LetsCodeBlacksburg/arduino-talking-skull/LCBB_Talking-Skull_Pt-2_Hware-Hacking-Guide.pdf

# Let’s Code Halloween Talking Skull Workshop Part-2 - Hardware Hacking Guide

# - Required Tools - Skull / Jaw-Servo Mod - Jaw Demo Video - Inline Resistors & LED Eyes

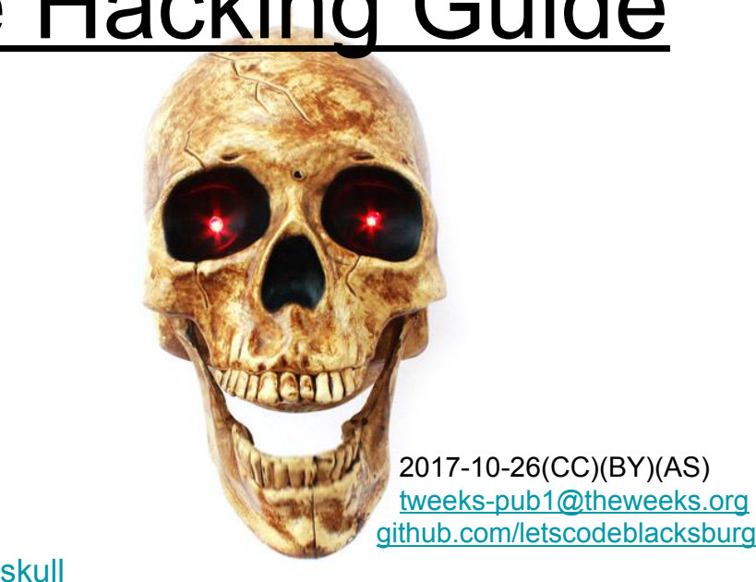
[picture p10: figure]
tweeks-pub1@theweeks.org

- Hardware Mounting` | 2017-10-26(CC)(BY)(AS)
Parts 1 & 2, parts list & source code all available at: | github.com/letscodeblacksburg
https://github.com/LetsCodeBlacksburg/arduino-talking-skull

# Required Tools

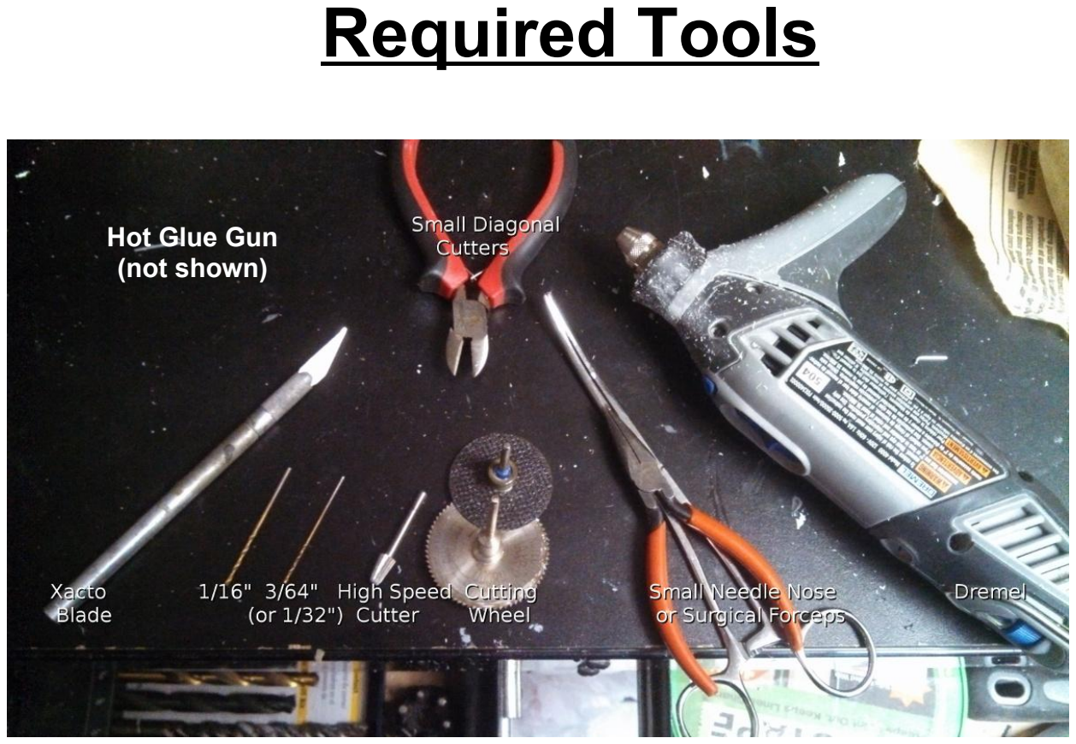
[picture p11: page 2]

Hot Glue Gun
(not shown)

# Skull Jaw Mods

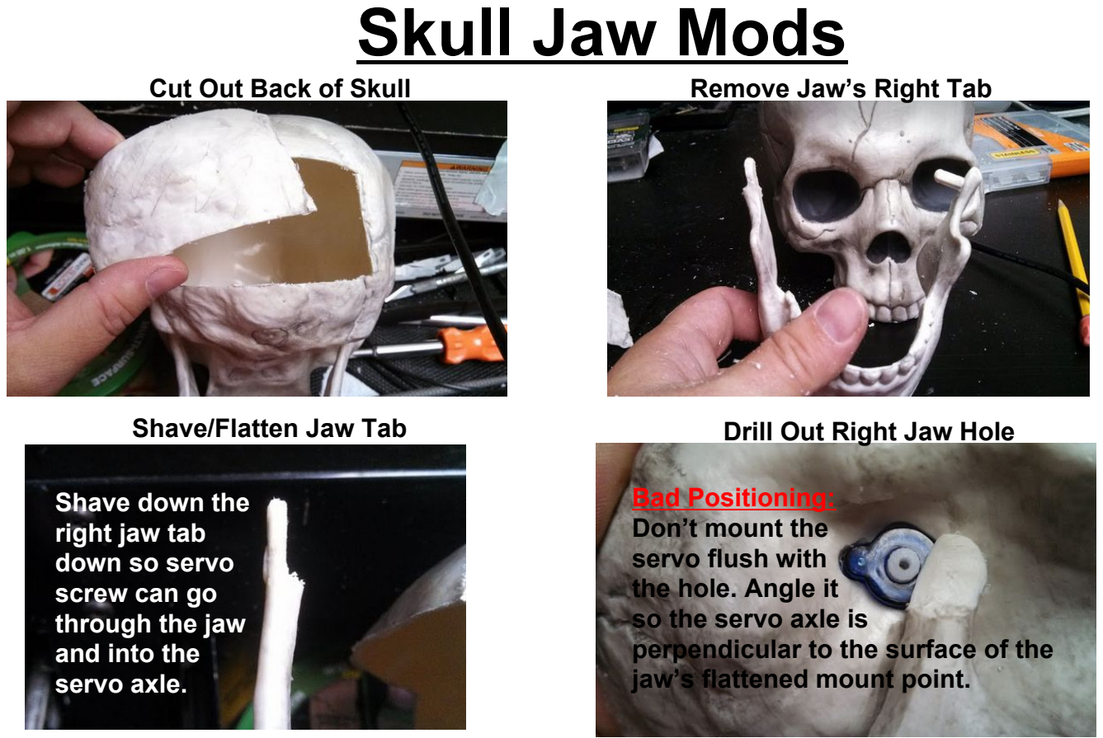
[picture p12: page 3]

Cut Out Back of Skull | Remove Jaw’s Right Tab

Drill Out Right Jaw Hole

Bad Positioning:
Don’t mount the
servo flush with
the hole. Angle it
so the servo axle is
perpendicular to the surface of the jaw’s flattened mount point.

Shave/Flatten Jaw Tab

Shave down the
right jaw tab
down so servo
screw can go
through the jaw
and into the
servo axle.

# Skull Jaw Mods

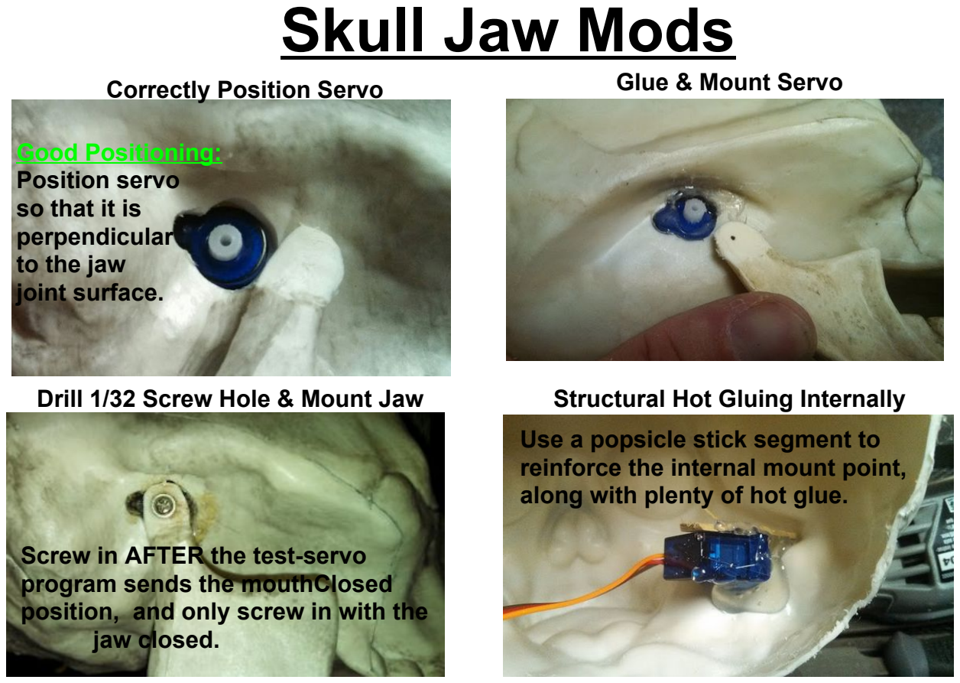
[picture p13: page 4]

Glue & Mount Servo

Drill 1/32 Screw Hole & Mount Jaw | Structural Hot Gluing Internally

Screw in AFTER the test-servo program sends the mouthClosed position, and only screw in with the jaw closed.

Use a popsicle stick segment to reinforce the internal mount point, along with plenty of hot glue.

Good Positioning:
Position servo
so that it is
perpendicular
to the jaw
joint surface.

Correctly Position Servo

# Jaw Functionality Demo

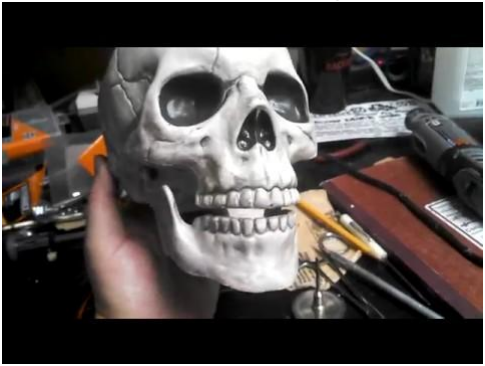
[picture p14: figure]

Inline Resistors | LED Eyes

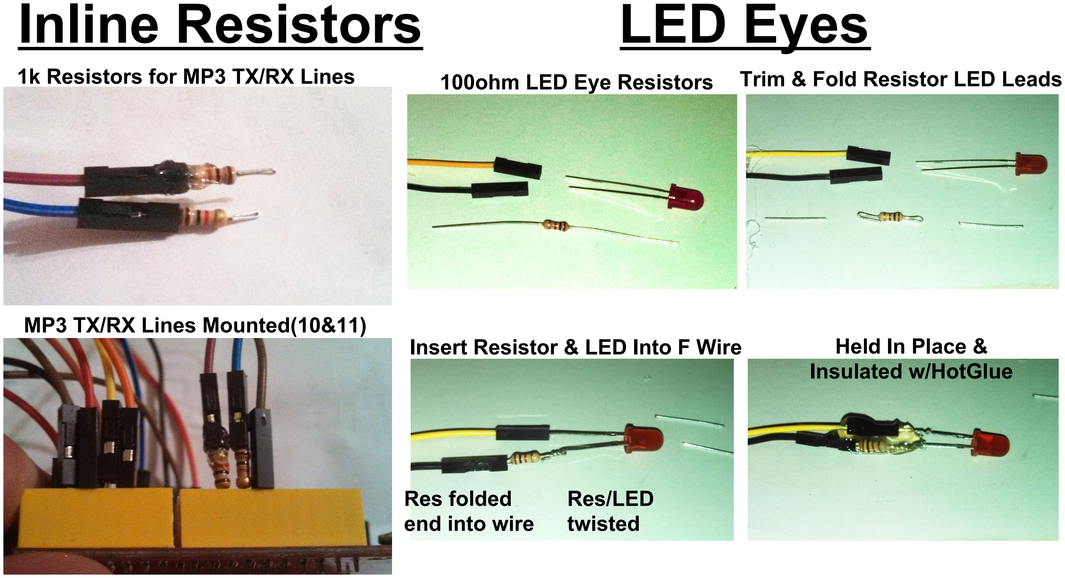
[picture p15: page 6]

1k Resistors for MP3 TX/RX Lines

MP3 TX/RX Lines Mounted(10&11)

100ohm LED Eye Resistors Trim & Fold Resistor LED Leads

Insert Resistor & LED Into F Wire

Res folded | Res/LED
end into wire | twisted

Held In Place &
Insulated w/HotGlue

# Arduino & MP3 Board Installs

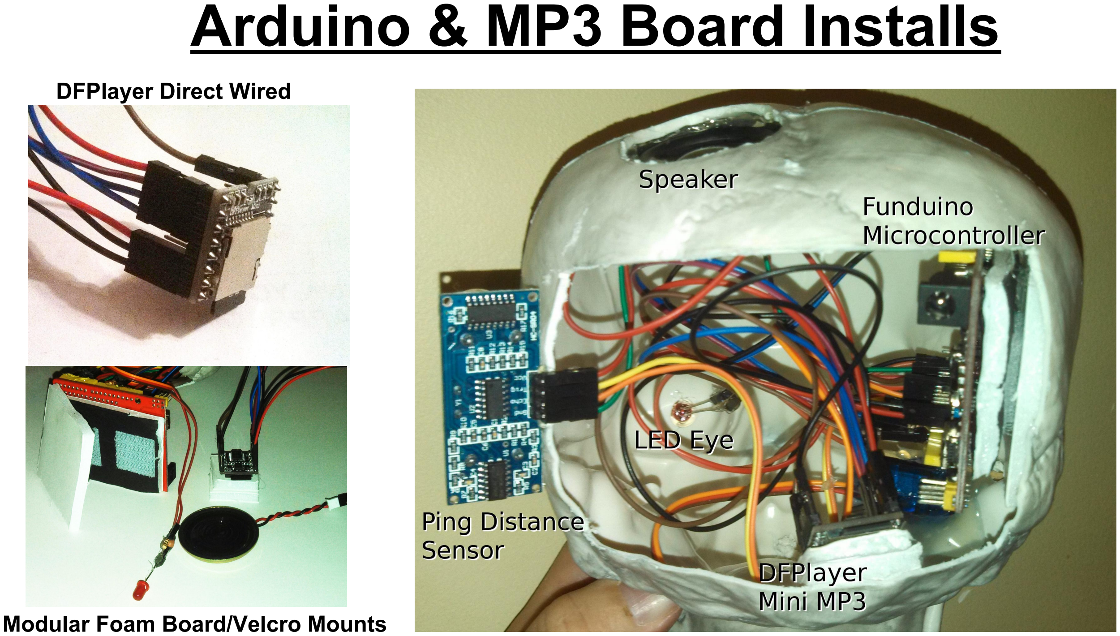
[picture p16: page 7]

DFPlayer Direct Wired

Modular Foam Board/Velcro Mounts
