LetsCodeBlacksburg/arduino-talking-skull/(commit log)

2017-10-15 Servo test code.
2017-10-15 added servo
2017-10-23 Updated all servo code..
2017-10-26 Fixed a couple of bugs, comments, and renamed files 2, 3, 4, 5
    [LCBB_Talking-Skull_2_servo-skull-test.ino, LCBB_Talking-Skull_2_servo-test.ino, LCBB_Talking-Skull_3_ping-test.ino, LCBB_Talking-Skull_4_dfplayer-test.ino, LCBB_Talking-Skull_5_ping-servo-dfplayer_complete.ino]
2017-10-26 updated with new parts list.. and more current details.
